lexxai/SmartKitchen-Cooker-Hoods/README.md

# SmartKitchen-Cooker-Hoods
Fan Controler of Cooker-Hoods for Smart Kitchen

Used Arduino-Pro-Mini.

Shema:
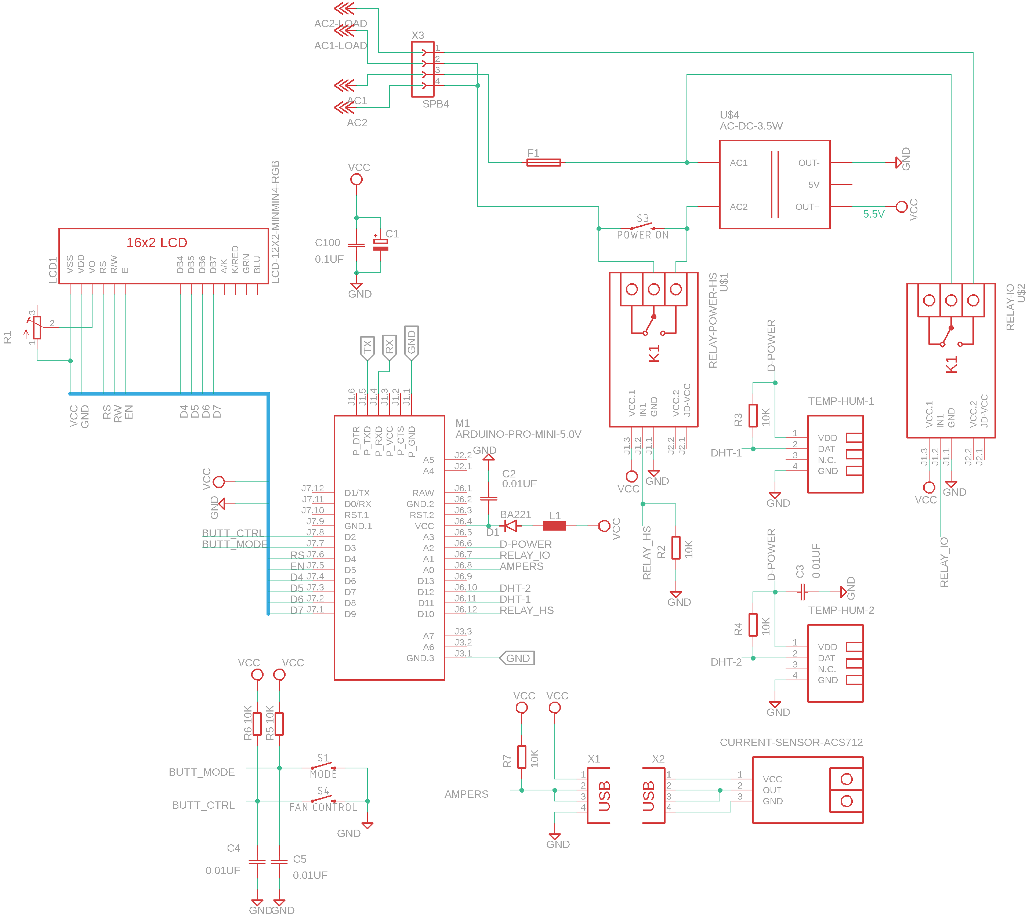
[picture p1: Shema/Smart-Kitchen-autofan.png]
shema


Gallery:
<table>
<tr>  
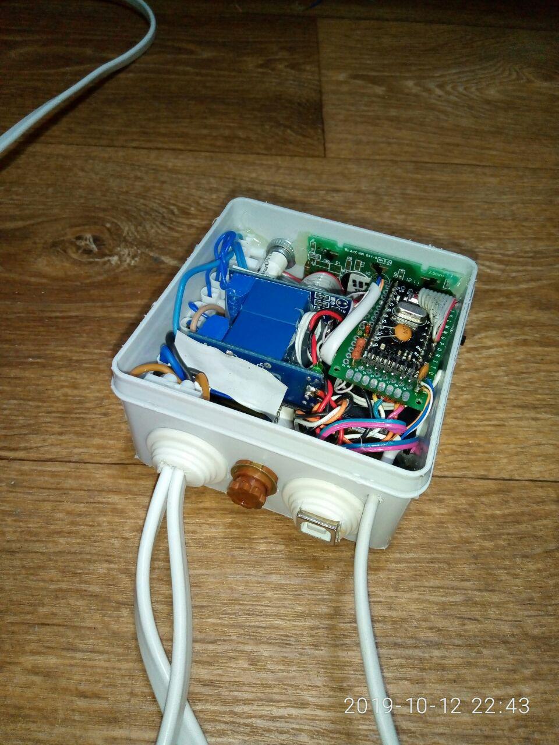
[picture p2: img/photo_2019-12-12_20-09-31.jpg]
<td>
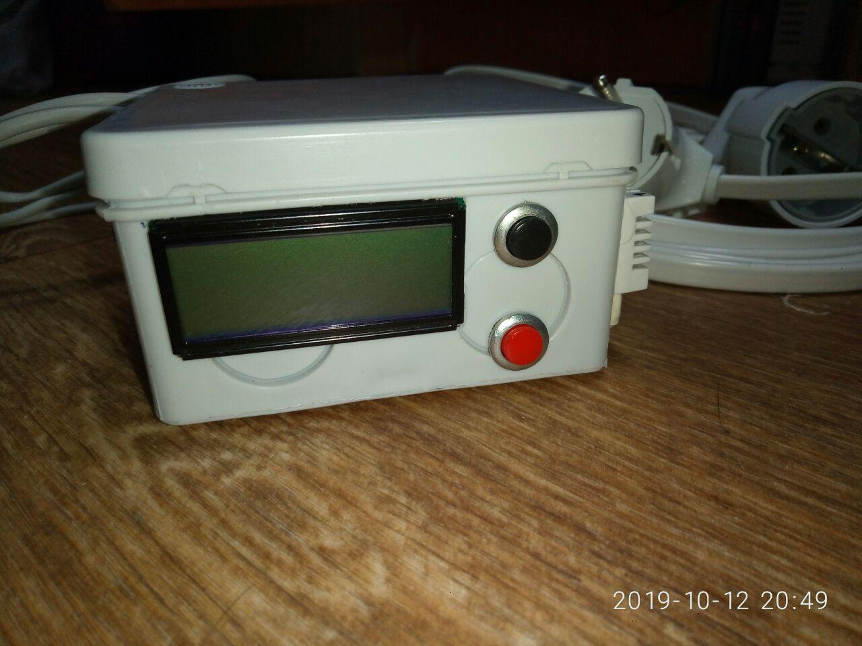
[picture p3: img/photo_2019-12-12_20-09-41.jpg]
<td>
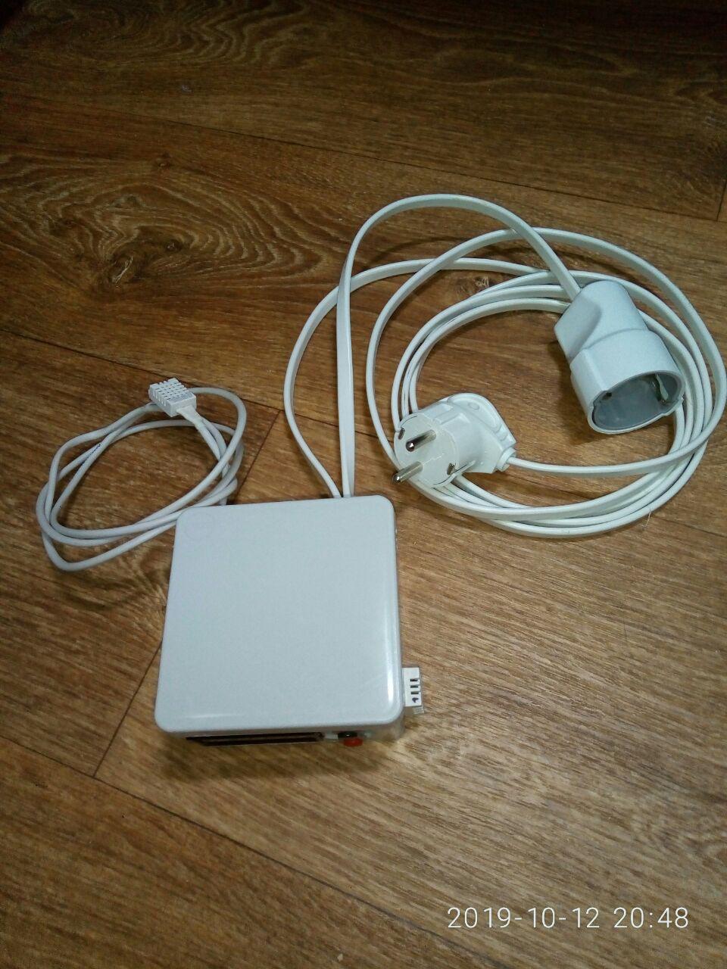
[picture p4: img/photo_2019-12-12_20-09-47.jpg]
<td>
</tr> 
<tr>    
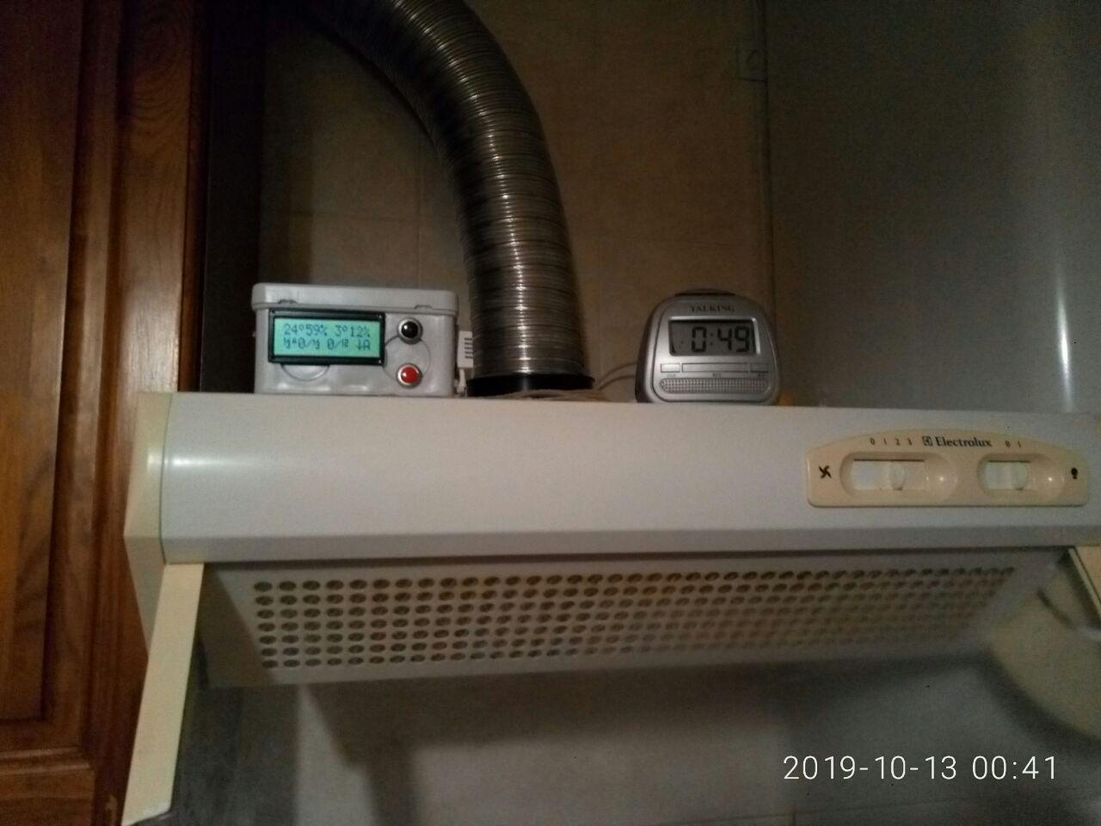
[picture p5: img/photo_2019-12-12_20-09-57.jpg]
<td>
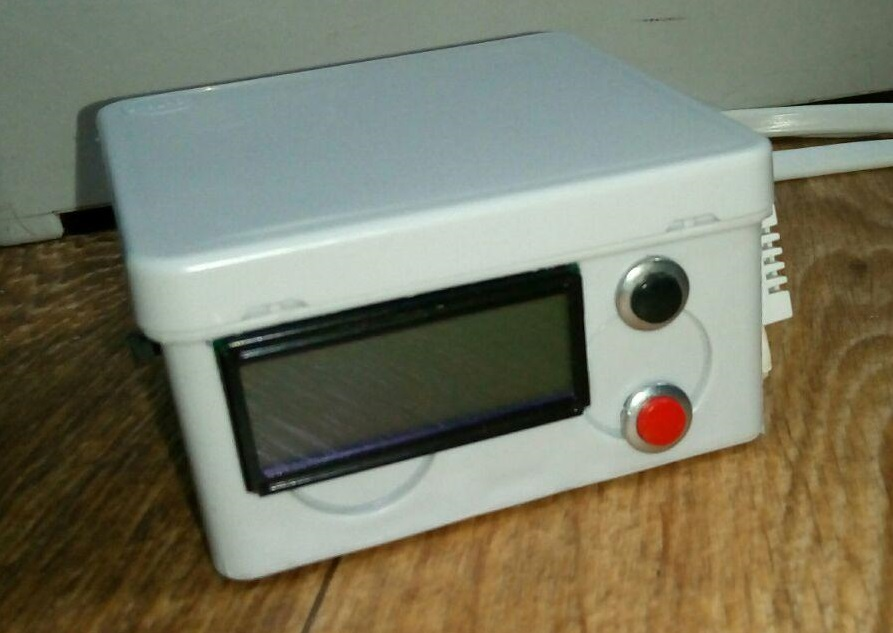
[picture p6: img/photo_2019-12-12_20-11-52.jpg]
<td>
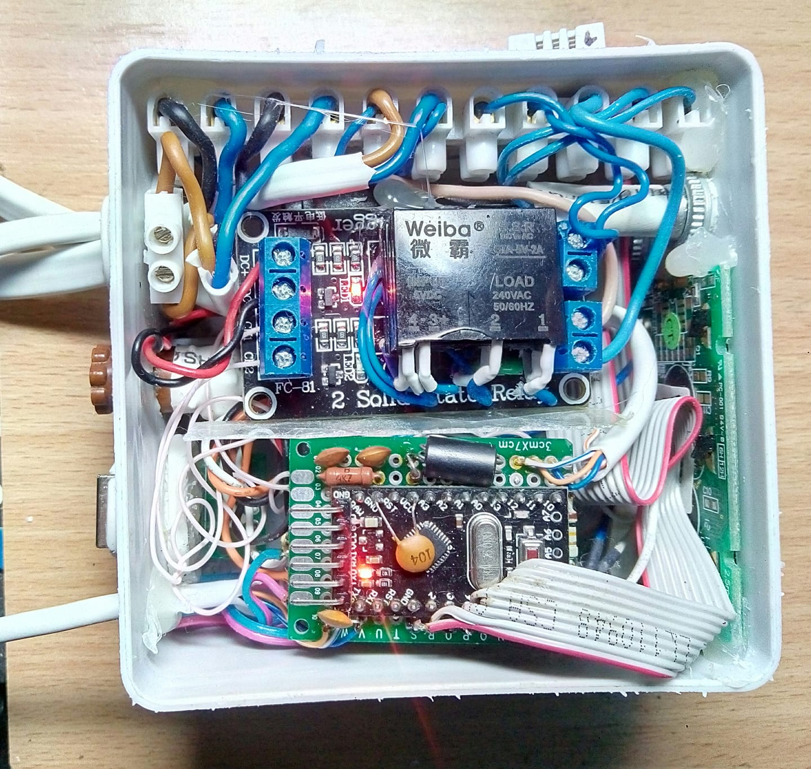
[picture p7: img/95892284_2977492062319910_3039895423096455168_o.jpg]
<td>
</tr>
</table>
