lexxai/SmartKitchen-Cooker-Hoods/Shema/smart-kitchen-autofan.sch

## EAGLE design Shema/smart-kitchen-autofan.sch (2019-12-12)

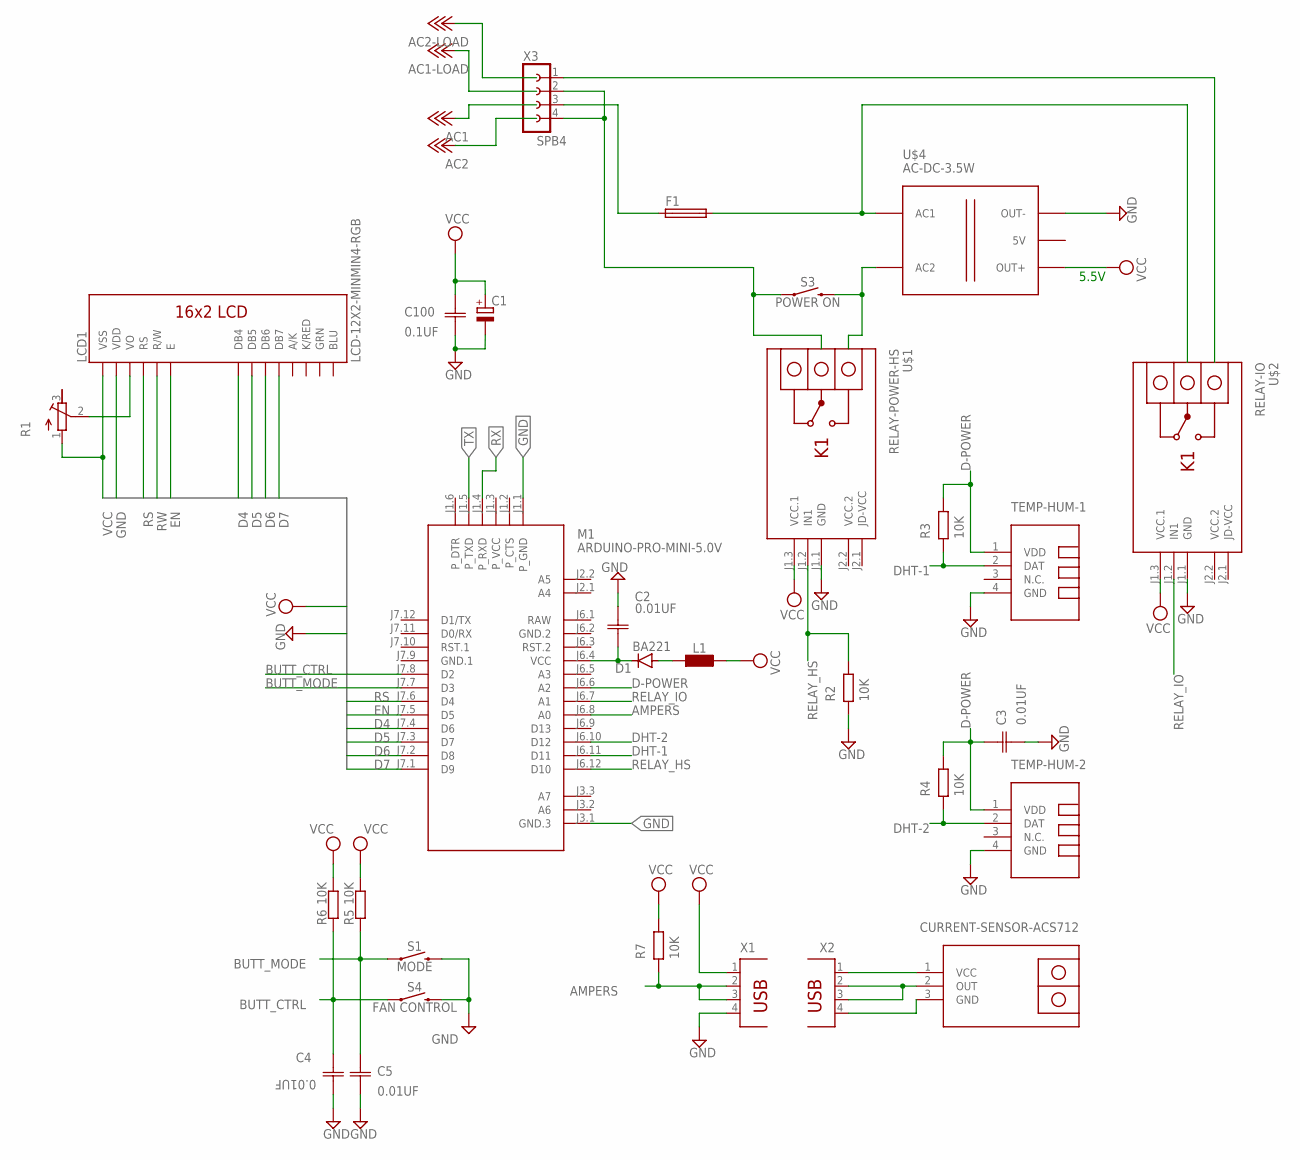
[picture p8: schematic smart-kitchen-autofan.sch]

Parts:
C1: CPOL-EU139CLL-2R; 139CLL-2R
C2, C3, C4, C5: 0.01UF; CAPC1608X90N
C100: 0.1UF; CAPC1608X90N
D1: BA221; DO35-10
F1: F457
L1: L0207/10; 0207/10
LCD1: LCD-12X2-MINMIN4-RGB; LCD-16X2_NOSILK-KIT-4BIT
M1: ARDUINO-PRO-MINI-5.0V; ARDUINO-PRO-MINI
R1: R-TRIMM5W; RTRIM5W
S1: MODE; TACTILE_SWITCH_PTH_6.0MM
S3: POWER ON; TACTILE_SWITCH_PTH_6.0MM
S4: FAN CONTROL; TACTILE_SWITCH_PTH_6.0MM
U$1: RELAY-POWER-HS; RELAY-1-SRD
U$2: RELAY-IO; RELAY-1-SRD
U$3: CURRENT-SENSOR-ACS712
U$4: AC-DC-3.5W
U$7: TEMP-HUM-1; TEMP-HUM-SENSOR-DHT22
U$8: TEMP-HUM-2; TEMP-HUM-SENSOR-DHT22
X1, X2: PN61729
X3: SPB4

Connections:
AMPERS: M1.J6.8 (A0), X1.2, X1.3
BUTT_CTRL: C4.1 (C1), M1.J7.8 (D2), S4.1
BUTT_MODE: C5.1 (C1), M1.J7.7 (D3), S1.1
D4: LCD1.11 (DB4), M1.J7.4 (D6)
D5: LCD1.12 (DB5), M1.J7.3 (D7)
D6: LCD1.13 (DB6), M1.J7.2 (D8)
D7: LCD1.14 (DB7), M1.J7.1 (D9)
D-POWER: C3.2 (C2), M1.J6.6 (A2), U$7.1 (VDD), U$8.1 (VDD)
DHT-1: M1.J6.11 (D11), U$7.2 (DAT)
DHT-2: M1.J6.10 (D12), U$8.2 (DAT)
EN: LCD1.6 (E), M1.J7.5 (D5)
GND: C1.-, C2.2 (C2), C3.1 (C1), C4.2 (C2), C5.2 (C2), C100.1 (C1), LCD1.2 (VDD), M1.J1.1 (P_GND), M1.J3.1 (GND.3), S1.3 (2), S4.3 (2), U$1.J1.1 (GND), U$2.J1.1 (GND), U$4.J2.1 (OUT-), U$7.4 (GND), U$8.4 (GND), X1.4
GND1: C2.1 (C1), D1.C, M1.J6.4 (VCC)
unnamed: S3.3 (2), U$4.J1.2 (AC2)
unnamed: F1.2, U$4.J1.1 (AC1)
unnamed: S3.1, X3.2, X3.4
unnamed: F1.1, X3.3
unnamed: U$3.2 (OUT), X2.2, X2.3
unnamed: D1.A, L1.2
unnamed: U$3.1 (VCC), X2.1
unnamed: U$3.3 (GND), X2.4
unnamed: LCD1.3 (VO), R1.2 (S)
RELAY_HS: M1.J6.12 (D10), U$1.J1.2 (IN1)
RELAY_IO: M1.J6.7 (A1), U$2.J1.2 (IN1)
RS: LCD1.4 (RS), M1.J7.6 (D4)
RW: LCD1.5 (R/W)
RX: M1.J1.4 (P_RXD)
TX: M1.J1.5 (P_TXD)
VCC: C1.+, C100.2 (C2), L1.1, LCD1.1 (VSS), R1.1 (A), U$1.J1.3 (VCC.1), U$2.J1.3 (VCC.1), U$4.J2.3 (OUT+), X1.1

Notes on the sheet:
5.5V
