lexxai/SmartKitchen-Cooker-Hoods/(commit log)

2019-12-12 init C files
    added eclipse project
    [smart-kitchen-autofan.sch]
2020-05-04 Sold State Relay
2020-05-04 Update to img with Solid State Relay
2020-05-04 Error detection
    Added Power Line control for DTH sensors
    For DTH error - reload Power Line
    For Amperes Error Display Char "X" instead of Amteres value.
    Tune Amperes value -0.3A.
    [SmartKitchen-Cooker-Hoods.cpp]
